5kakinotane5/lock-stand/model/dispenser_mock_plate.3mf

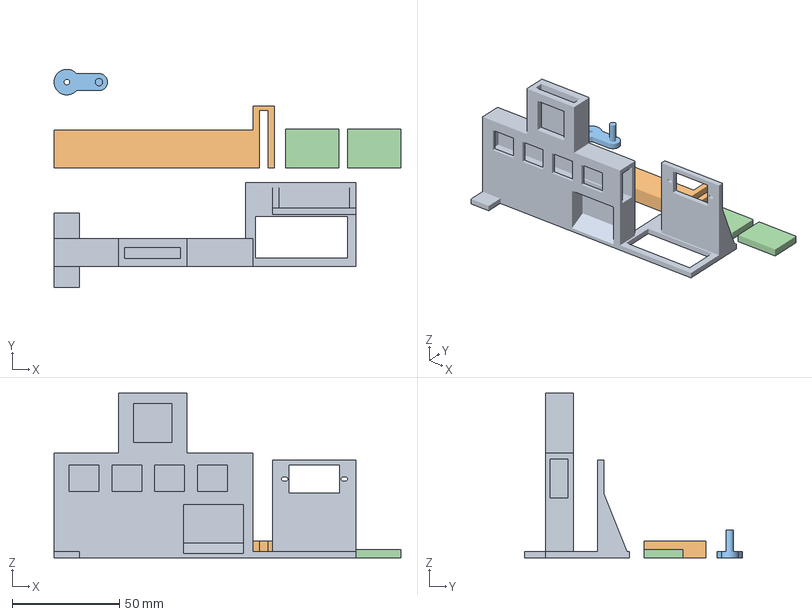
[picture p2: CAD file, 2026-10-26]
model/dispenser_mock_plate.3mf
162.0 x 102.0 x 77.0 mm
shuttle
crank
keys
