5kakinotane5/lock-stand/(commit log)

2026-10-15 初回コミット
2026-10-15 ファームウェアを追加し、ファイル構成を整理
    - 実証ステップ2・3のコードを追加（dispense.cpp, coin_unlock.cpp）
    - 3ステップをまとめる state_machine.cpp を追加
2026-10-15 feat: デモ用コードstate_machine.cppを追加
2026-10-25 docs:ディスペンサーのシミュレーションを追加
2026-10-26 add:Create stand_controller.cpp(ディスペンサーモック用の組み込みコード)を追加
2026-10-26 add:ディスペンサー部分の３Dモデルを追加
    [dispenser_mock_plate.3mf]
